17-bnr/Contactless/README.md

# Contactless
for Tokyo Tech Festival 2022
