17-bnr/Contactless/(list of files, cad)

Other CAD files:
Inventor/Dai/Dai.iam
Inventor/Dai/Dai.ipt
Inventor/Dai/DaiUe.ipt
Inventor/Dai/Naname.ipt
Inventor/Dai/OldVersions/Dai.0006.iam
Inventor/Dai/OldVersions/Dai.0006.ipt
Inventor/Dai/OldVersions/DaiUe.0001.ipt
Inventor/Dai/OldVersions/Naname.0003.ipt
Inventor/Dai/OldVersions/Shita.0002.ipt
Inventor/Dai/OldVersions/Tate.0004.ipt
Inventor/Dai/Shita.ipt
Inventor/Dai/Soko.ipt
Inventor/Dai/Tate.ipt
Inventor/Kitai/ConPCB.ipt
Inventor/Kitai/Dai.ipt
Inventor/Kitai/Gamen.ipt
Inventor/Kitai/IndiPCB.ipt
Inventor/Kitai/Ita.ipt
Inventor/Kitai/Kitai.iam
Inventor/Kitai/OldVersions/Dai.0004.ipt
Inventor/Kitai/OldVersions/Ita.0001.ipt
Inventor/Kitai/OldVersions/Kitai.0011.iam
Inventor/Kitai/OldVersions/SokuTate.0003.ipt
Inventor/Kitai/OldVersions/SokuYokoUe.0001.ipt
Inventor/Kitai/OldVersions/Tate.0004.ipt
Inventor/Kitai/OldVersions/Yoko.0002.ipt
Inventor/Kitai/OldVersions/YokoUe.0003.ipt
Inventor/Kitai/SokuTate.ipt
Inventor/Kitai/SokuYoko.ipt
Inventor/Kitai/SokuYokoUe.ipt
Inventor/Kitai/Tate.ipt
Inventor/Kitai/Yoko.ipt
Inventor/Kitai/YokoUe.ipt
