17-bnr/Contactless/LTspice/SoundSim.asc

V1: voltage; PULSE(0 3.3 0 1u 1u 1.28m 2.55m)
Named nets: 0, out
.wave output.wav 16 44.1k V(out)
.tran 1
