17-bnr/Contactless/EAGLE/ContactlessIndi/ContactlessIndi.brd

## EAGLE design EAGLE/ContactlessIndi/ContactlessIndi.brd (2022-10-10)

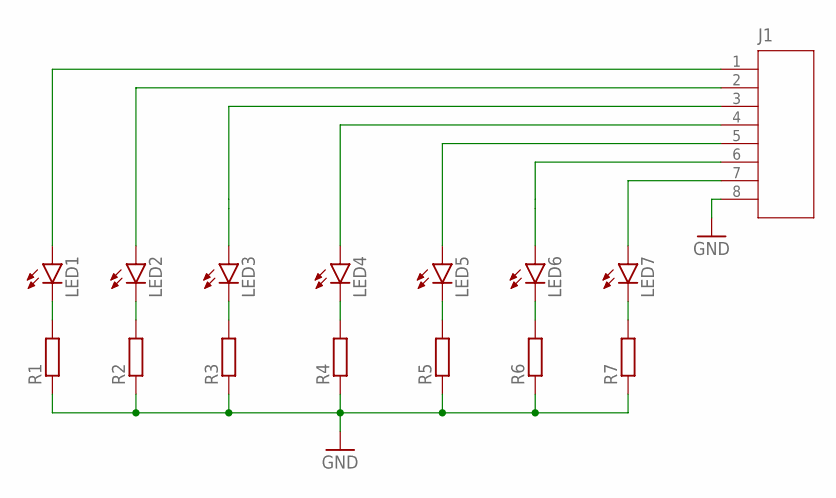
[picture p1: schematic ContactlessIndi.sch]

Parts:
J1: PINHEADER-818*1; PINHEADER-8*1
LED1, LED2, LED3, LED4, LED5, LED6, LED7: LED5MM
R1, R2, R3, R4, R5, R6, R7: R-EU_R1206; R1206

Connections:
GND: J1.8, R1.1, R2.1, R3.1, R4.1, R5.1, R6.1, R7.1
unnamed: LED1.K (C), R1.2
unnamed: LED2.K (C), R2.2
unnamed: LED3.K (C), R3.2
unnamed: LED4.K (C), R4.2
unnamed: LED5.K (C), R5.2
unnamed: LED6.K (C), R6.2
unnamed: LED7.K (C), R7.2
unnamed: J1.7, LED7.A
unnamed: J1.6, LED6.A
unnamed: J1.5, LED5.A
unnamed: J1.4, LED4.A
unnamed: J1.3, LED3.A
unnamed: J1.2, LED2.A
unnamed: J1.1, LED1.A

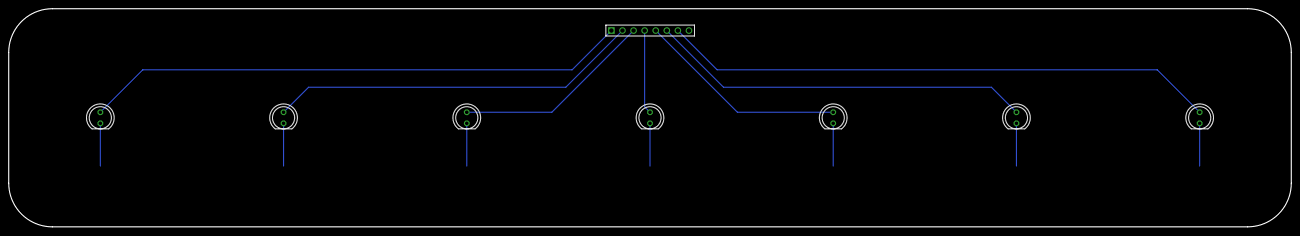
[picture p2: board ContactlessIndi.brd from above]

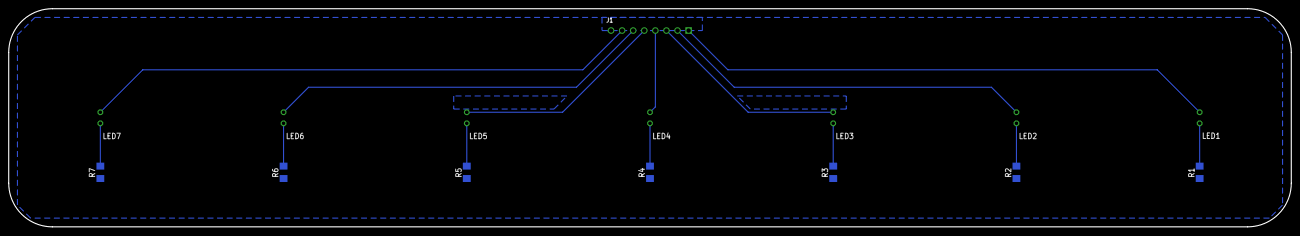
[picture p3: board ContactlessIndi.brd from below]

Board: 2 copper layers, 294.0 x 50.0 mm, 15 parts (7 on the bottom side), 15 nets.
