17-bnr/Contactless/EAGLE/ContactlessMain/ContactlessMain.brd

## EAGLE design EAGLE/ContactlessMain/ContactlessMain.brd (2022-10-10)

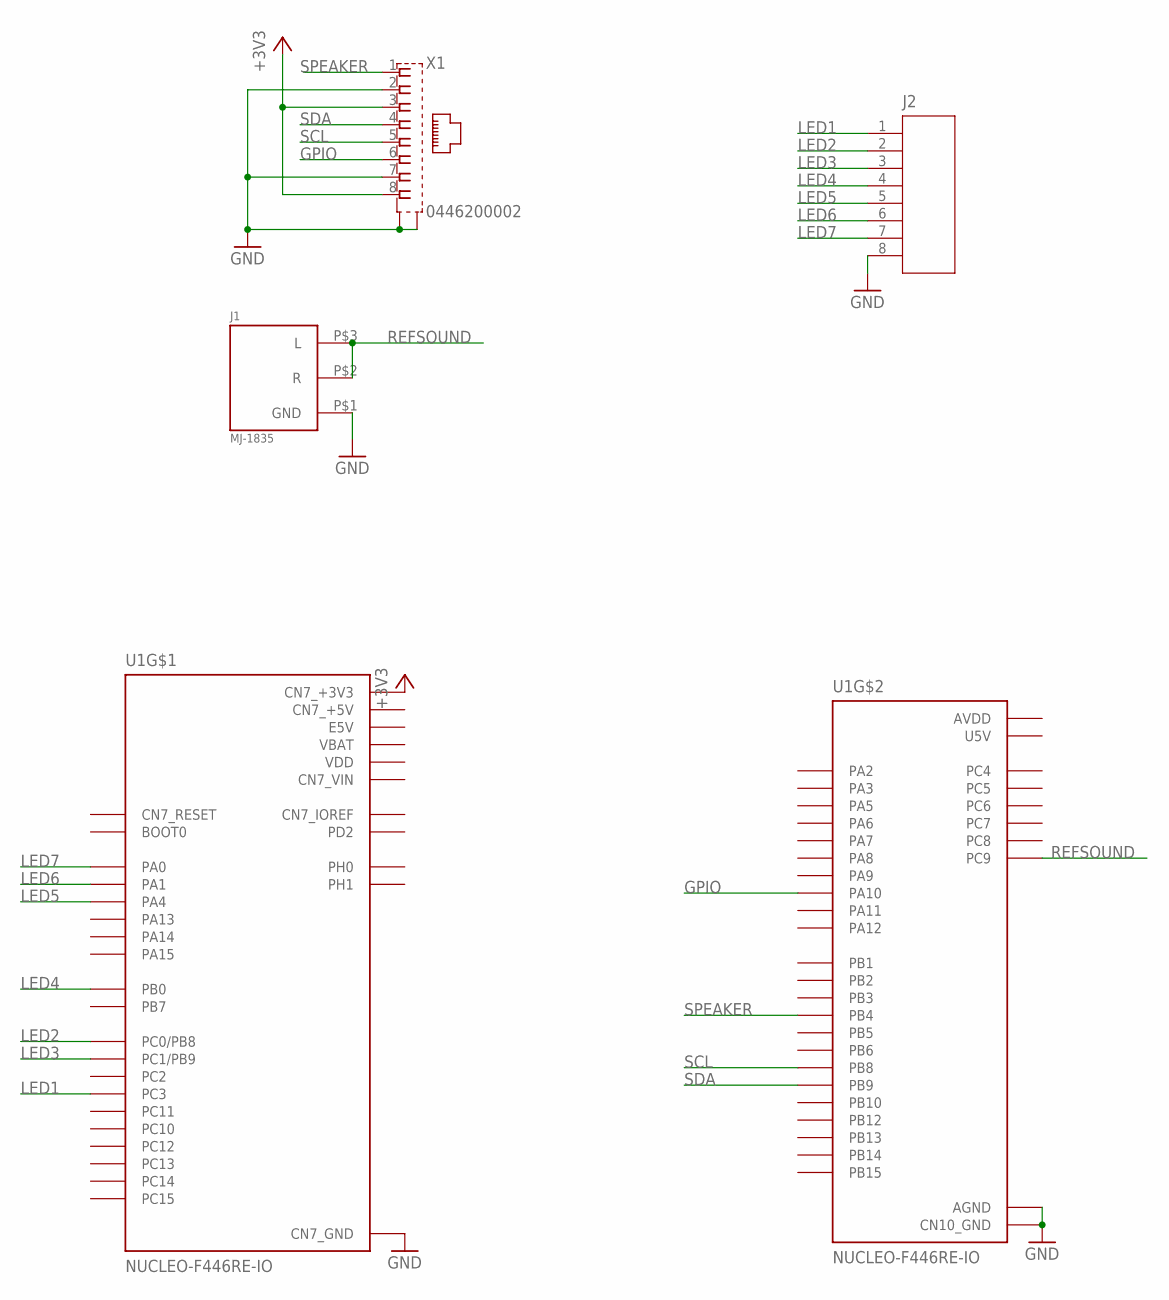
[picture p4: schematic ContactlessMain.sch]

Parts:
J1: MJ-1835
J2: PINHEADER-818*1; PINHEADER-8*1
U1: NUCLEO-F446RE-IO; MODULE_NUCLEO-F446RE
X1: 0446200002

Connections:
+3V3: U1.CN7_16 (CN7_+3V3), X1.3, X1.8
AVDD: U1.CN10_7 (AVDD)
CN7_+5V: U1.CN7_18 (CN7_+5V)
CN7_VIN: U1.CN7_24 (CN7_VIN)
E5V: U1.CN7_6 (E5V)
GND: J1.P$1 (GND), J2.8, U1.CN7_8 (CN7_GND), U1.CN7_19 (CN7_GND), U1.CN7_20 (CN7_GND), U1.CN7_22 (CN7_GND), U1.CN10_9 (CN10_GND), U1.CN10_20 (CN10_GND), U1.CN10_32 (AGND), X1.2, X1.7, X1.S@1 (S1), X1.S@2 (S2)
GPIO: U1.CN10_33 (PA10), X1.6
LED1: J2.1, U1.CN7_37 (PC3)
LED2: J2.2, U1.CN7_38 (PC0/PB8)
LED3: J2.3, U1.CN7_36 (PC1/PB9)
LED4: J2.4, U1.CN7_34 (PB0)
LED5: J2.5, U1.CN7_32 (PA4)
LED6: J2.6, U1.CN7_30 (PA1)
LED7: J2.7, U1.CN7_28 (PA0)
REFSOUND: J1.P$2 (R), J1.P$3 (L), U1.CN10_1 (PC9)
SCL: U1.CN10_3 (PB8), X1.5
SDA: U1.CN10_5 (PB9), X1.4
SPEAKER: U1.CN10_27 (PB4), X1.1
U5V: U1.CN10_8 (U5V)
VBAT: U1.CN7_33 (VBAT)
VDD: U1.CN7_5 (VDD)

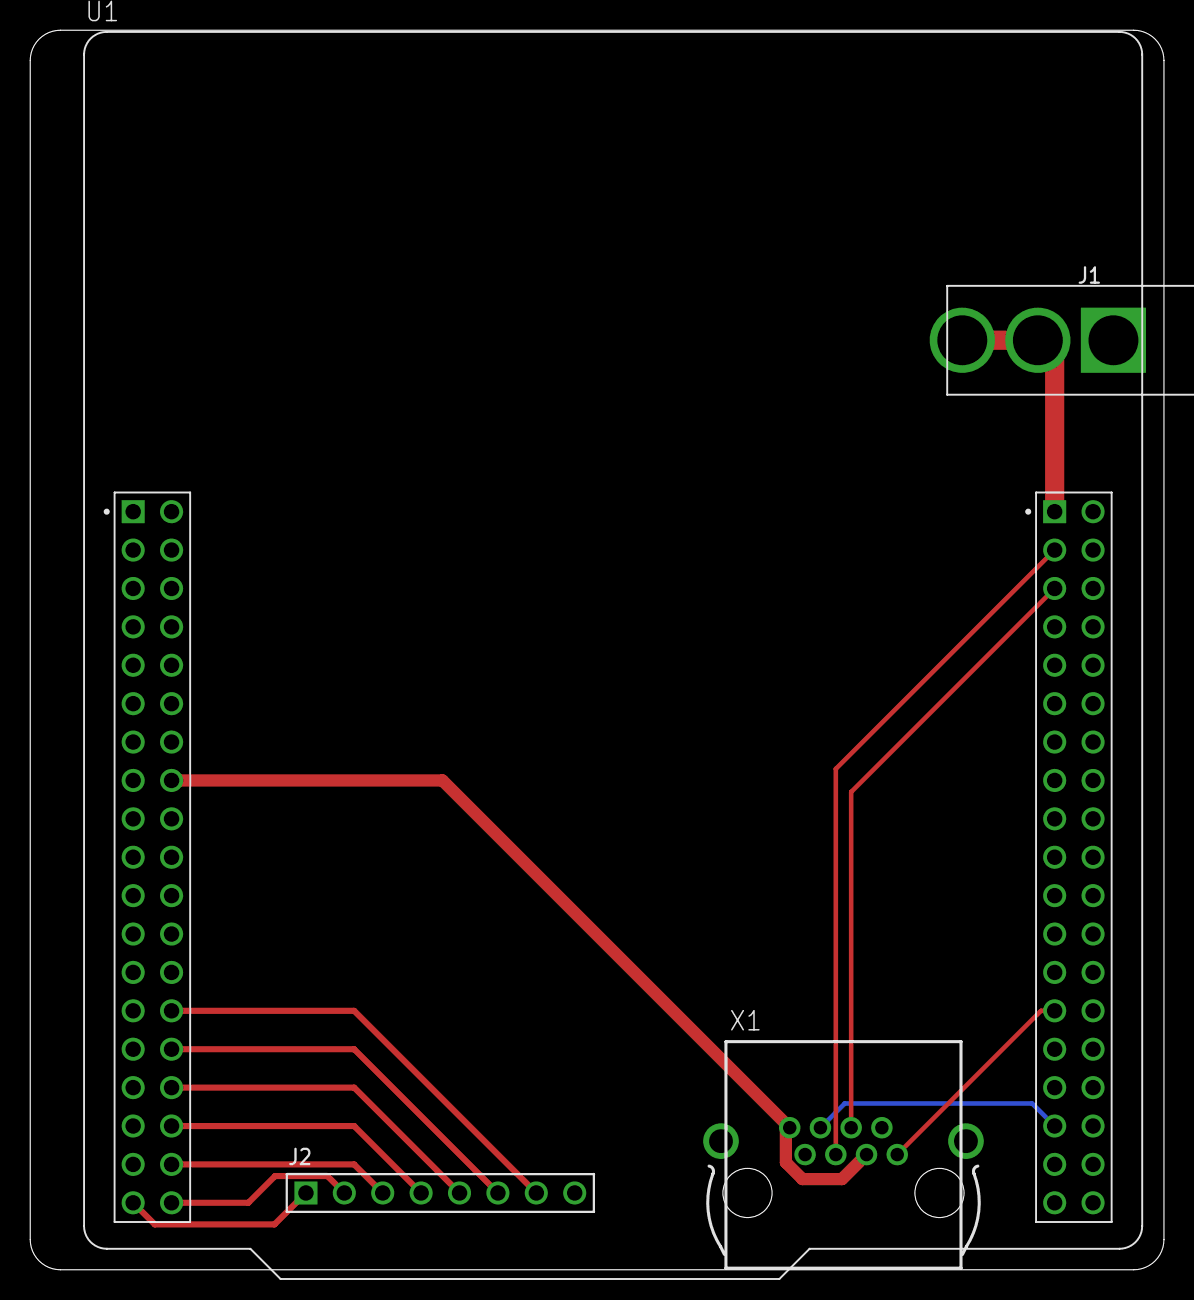
[picture p5: board ContactlessMain.brd from above]

Board: 2 copper layers, 75.0 x 82.0 mm, 4 parts (0 on the bottom side), 14 nets.
