17-bnr/Contactless/EAGLE/ContactlessCon/ContactlessCon.brd

## EAGLE design EAGLE/ContactlessCon/ContactlessCon.brd (2022-10-10)

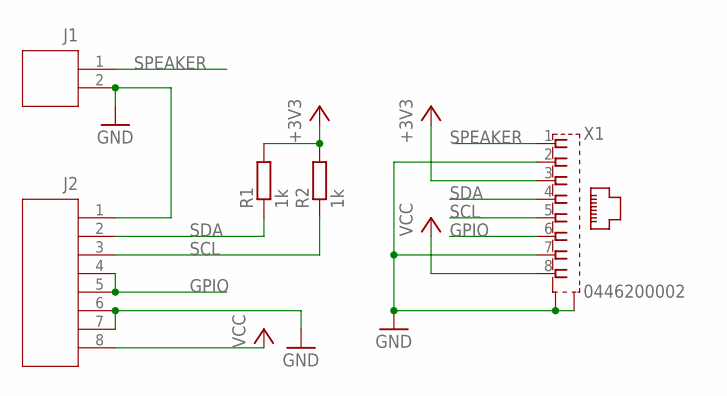
[picture p6: schematic ContactlessCon.sch]

Parts:
J1: PINHEADER-212*1; PINHEADER-2*1
J2: PINHEADER-818*1; PINHEADER-8*1
R1, R2: 1k; R1206
X1: 0446200002

Connections:
+3V3: R1.2, R2.2, X1.3
GND: J1.2, J2.1, J2.6, J2.7, X1.2, X1.7, X1.S@1 (S1), X1.S@2 (S2)
GPIO: J2.4, J2.5, X1.6
SCL: J2.3, R2.1, X1.5
SDA: J2.2, R1.1, X1.4
SPEAKER: J1.1, X1.1
VCC: J2.8, X1.8

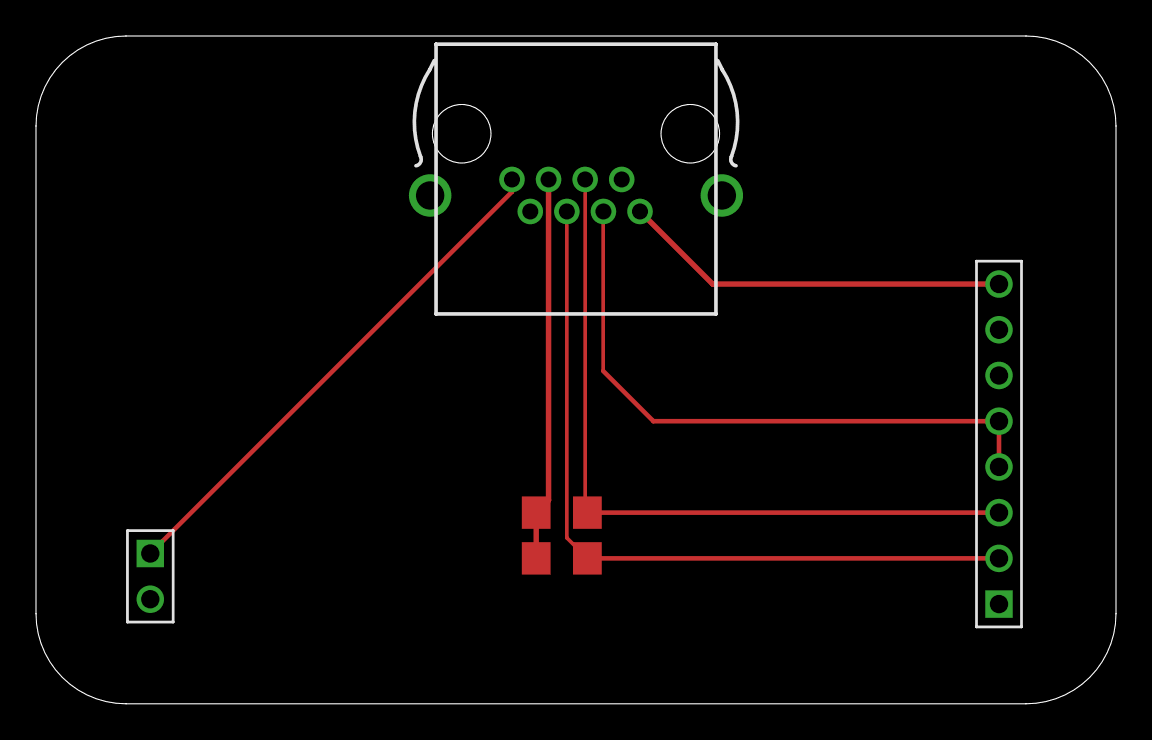
[picture p7: board ContactlessCon.brd from above]

Board: 2 copper layers, 60.0 x 37.1 mm, 5 parts (0 on the bottom side), 7 nets.
