17-bnr/Contactless/ContactlessNucleo/Core/Src/main.c

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
/* Includes ------------------------------------------------------------------*/
#include "main.h"

/* USER CODE BEGIN Includes */
#include "stdio.h"
#include "math.h"

/* USER CODE END Includes */

I2C_HandleTypeDef hi2c1;
DMA_HandleTypeDef hdma_i2c1_rx;
DMA_HandleTypeDef hdma_i2c1_tx;

TIM_HandleTypeDef htim2;
TIM_HandleTypeDef htim3;
TIM_HandleTypeDef htim8;

UART_HandleTypeDef huart2;
DMA_HandleTypeDef hdma_usart2_tx;

/* USER CODE BEGIN PV */
const static uint16_t address = 0x80;
const static uint16_t addressR = address+1;
static uint8_t rx_buf[2] = {};
static uint8_t tx_on_buf[2] = {0xE8,0x00};
static uint8_t tx_off_buf[2] = {0xE8,0x01};
static uint8_t tx_buf[1] = {0x5E};
static uint32_t tone_array[12]
= {53639,50540,47780,45015,42552,40114,37837,35713,33734,31817,30042,28339};
/* USER CODE END PV */

void SystemClock_Config(void);
static void MX_DMA_Init(void);
static void MX_I2C1_Init(void);
static void MX_TIM2_Init(void);
static void MX_USART2_UART_Init(void);
static void MX_GPIO_Init(void);
static void MX_TIM3_Init(void);
static void MX_TIM8_Init(void);
/* USER CODE BEGIN 0 */
enum Tone {C=0,Cs,D,Ef,E,F,Fs,G,Gs,A,Bf,B,none};
enum Tone ASpeakerOn(uint16_t distance)
{
  switch (distance)
  {
  case 3: case 4:
    TIM3->ARR = tone_array[C];
    TIM3->CCR1 = (TIM3->ARR)/2;
    HAL_TIM_PWM_Start(&htim3,TIM_CHANNEL_1);
    return C;
    break;
  case 5: case 6:
    TIM3->ARR = tone_array[Cs];
    TIM3->CCR1 = (TIM3->ARR)/2;
    HAL_TIM_PWM_Start(&htim3,TIM_CHANNEL_1);
    return Cs;
  case 7: case 8:
    TIM3->ARR = tone_array[D];
    TIM3->CCR1 = (TIM3->ARR)/2;
    HAL_TIM_PWM_Start(&htim3,TIM_CHANNEL_1);
    return D;
  case 9: case 10:
    TIM3->ARR = tone_array[Ef];
    TIM3->CCR1 = (TIM3->ARR)/2;
    HAL_TIM_PWM_Start(&htim3,TIM_CHANNEL_1);
    return Ef;
  case 11: case 12: case 13:
    TIM3->ARR = tone_array[E];
    TIM3->CCR1 = (TIM3->ARR)/2;
    HAL_TIM_PWM_Start(&htim3,TIM_CHANNEL_1);
    return E;
  case 14: case 15: case 16:
    TIM3->ARR = tone_array[F];
    TIM3->CCR1 = (TIM3->ARR)/2;
    HAL_TIM_PWM_Start(&htim3,TIM_CHANNEL_1);
    return F;
  case 17: case 18: case 19: case 20:
    TIM3->ARR = tone_array[Fs];
    TIM3->CCR1 = (TIM3->ARR)/2;
    HAL_TIM_PWM_Start(&htim3,TIM_CHANNEL_1);
    return Fs;
  case 21: case 22: case 23: case 24:
    TIM3->ARR = tone_array[G];
    TIM3->CCR1 = (TIM3->ARR)/2;
    HAL_TIM_PWM_Start(&htim3,TIM_CHANNEL_1);
    return G;
  case 25: case 26: case 27: case 28:
    TIM3->ARR = tone_array[Gs];
    TIM3->CCR1 = (TIM3->ARR)/2;
    HAL_TIM_PWM_Start(&htim3,TIM_CHANNEL_1);
    return Gs;
  case 29: case 30: case 31: case 32: case 33: case 34:
    TIM3->ARR = tone_array[A];
    TIM3->CCR1 = (TIM3->ARR)/2;
    HAL_TIM_PWM_Start(&htim3,TIM_CHANNEL_1);
    return A;
  case 35: case 36: case 37: case 38: 
    TIM3->ARR = tone_array[Bf];
    TIM3->CCR1 = (TIM3->ARR)/2;
    HAL_TIM_PWM_Start(&htim3,TIM_CHANNEL_1);
    return Bf;
  case 39: case 40: case 41: case 42:
    TIM3->ARR = tone_array[B];
    TIM3->CCR1 = (TIM3->ARR)/2;
    HAL_TIM_PWM_Start(&htim3,TIM_CHANNEL_1);
    return B;
  default:
    HAL_TIM_PWM_Stop(&htim3,TIM_CHANNEL_1);
    return none;
    break;
  }
}

enum Tone SpeakerOn(uint16_t distance)
{
  switch (distance)
  {
  case 3: case 4:
    TIM3->ARR = tone_array[C];
    TIM3->CCR1 = (TIM3->ARR)/2;
    HAL_TIM_PWM_Start(&htim3,TIM_CHANNEL_1);
    return C;
    break;
  case 5: case 6:
    TIM3->ARR = tone_array[Cs];
    TIM3->CCR1 = (TIM3->ARR)/2;
    HAL_TIM_PWM_Start(&htim3,TIM_CHANNEL_1);
    return Cs;
  case 7: case 8:
    TIM3->ARR = tone_array[D];
    TIM3->CCR1 = (TIM3->ARR)/2;
    HAL_TIM_PWM_Start(&htim3,TIM_CHANNEL_1);
    return D;
  case 9: case 10:
    TIM3->ARR = tone_array[Ef];
    TIM3->CCR1 = (TIM3->ARR)/2;
    HAL_TIM_PWM_Start(&htim3,TIM_CHANNEL_1);
    return Ef;
  case 11: case 12: case 13:
    TIM3->ARR = tone_array[E];
    TIM3->CCR1 = (TIM3->ARR)/2;
    HAL_TIM_PWM_Start(&htim3,TIM_CHANNEL_1);
    return E;
  case 14: case 15: case 16:
    TIM3->ARR = tone_array[F];
    TIM3->CCR1 = (TIM3->ARR)/2;
    HAL_TIM_PWM_Start(&htim3,TIM_CHANNEL_1);
    return F;
  case 17: case 18: case 19: case 20:
    TIM3->ARR = tone_array[Fs];
    TIM3->CCR1 = (TIM3->ARR)/2;
    HAL_TIM_PWM_Start(&htim3,TIM_CHANNEL_1);
    return Fs;
  case 21: case 22: case 23: case 24:
    TIM3->ARR = tone_array[G];
    TIM3->CCR1 = (TIM3->ARR)/2;
    HAL_TIM_PWM_Start(&htim3,TIM_CHANNEL_1);
    return G;
  case 25: case 26: case 27: case 28:
    TIM3->ARR = tone_array[Gs];
    TIM3->CCR1 = (TIM3->ARR)/2;
    HAL_TIM_PWM_Start(&htim3,TIM_CHANNEL_1);
    return Gs;
  case 29: case 30: case 31: case 32: case 33:
    TIM3->ARR = tone_array[A];
    TIM3->CCR1 = (TIM3->ARR)/2;
    HAL_TIM_PWM_Start(&htim3,TIM_CHANNEL_1);
    return A;
  case 34: case 35: case 36: case 37: case 38: 
    TIM3->ARR = tone_array[Bf];
    TIM3->CCR1 = (TIM3->ARR)/2;
    HAL_TIM_PWM_Start(&htim3,TIM_CHANNEL_1);
    return Bf;
  case 39: case 40: case 41: case 42: case 43: 
    TIM3->ARR = tone_array[B];
    TIM3->CCR1 = (TIM3->ARR)/2;
    HAL_TIM_PWM_Start(&htim3,TIM_CHANNEL_1);
    return B;
  default:
    HAL_TIM_PWM_Stop(&htim3,TIM_CHANNEL_1);
    return none;
    break;
  }
}

void SpeakerOff()
{
  HAL_TIM_PWM_Stop(&htim3,TIM_CHANNEL_1);
}

void ASoundOn()
{
  TIM8->ARR = tone_array[A];
  TIM8->CCR4 = (TIM8->ARR)/2;
  HAL_TIM_PWM_Start(&htim8,TIM_CHANNEL_4);
}

void RefSoundOn(uint32_t time)
{
  TIM8->ARR = tone_array[time%12];
  TIM8->CCR4 = (TIM8->ARR)/2;
  HAL_TIM_PWM_Start(&htim8,TIM_CHANNEL_4);
}

void SoundOff()
{
  HAL_TIM_PWM_Stop(&htim8,TIM_CHANNEL_4);
}

enum GameMode {Wait,Start,Load,Game,Clear,Finish};
static enum GameMode mode = Wait;
static uint32_t time_counter = 0;
static uint32_t game_time = 0;
void HAL_TIM_PeriodElapsedCallback(TIM_HandleTypeDef *htim)
{
  if(htim==&htim2)
  {
    time_counter++;
    switch (mode)
    {
    case Wait:
      SpeakerOff();
      SoundOff();
      HAL_GPIO_WritePin(LED1_GPIO_Port,LED1_Pin,GPIO_PIN_SET);
      HAL_GPIO_WritePin(LED2_GPIO_Port,LED2_Pin,GPIO_PIN_SET);
      HAL_GPIO_WritePin(LED3_GPIO_Port,LED3_Pin,GPIO_PIN_SET);
      HAL_GPIO_WritePin(LED4_GPIO_Port,LED4_Pin,GPIO_PIN_RESET);
      HAL_GPIO_WritePin(LED5_GPIO_Port,LED5_Pin,GPIO_PIN_SET);
      HAL_GPIO_WritePin(LED6_GPIO_Port,LED6_Pin,GPIO_PIN_SET);
      HAL_GPIO_WritePin(LED7_GPIO_Port,LED7_Pin,GPIO_PIN_SET);
      HAL_I2C_Master_Transmit(&hi2c1,address,tx_on_buf,2,1);
      HAL_I2C_Master_Transmit_DMA(&hi2c1,address,tx_buf,1);
      break;
    case Start:
      ASoundOn();
      HAL_I2C_Master_Transmit(&hi2c1,address,tx_on_buf,2,1);
      HAL_I2C_Master_Transmit_DMA(&hi2c1,address,tx_buf,1);
      break;
    case Load:
      SpeakerOff();
      SoundOff();
      HAL_GPIO_WritePin(LED1_GPIO_Port,LED1_Pin,GPIO_PIN_RESET);
      HAL_GPIO_WritePin(LED2_GPIO_Port,LED2_Pin,GPIO_PIN_RESET);
      HAL_GPIO_WritePin(LED3_GPIO_Port,LED3_Pin,GPIO_PIN_RESET);
      HAL_GPIO_WritePin(LED4_GPIO_Port,LED4_Pin,GPIO_PIN_RESET);
      HAL_GPIO_WritePin(LED5_GPIO_Port,LED5_Pin,GPIO_PIN_RESET);
      HAL_GPIO_WritePin(LED6_GPIO_Port,LED6_Pin,GPIO_PIN_RESET);
      HAL_GPIO_WritePin(LED7_GPIO_Port,LED7_Pin,GPIO_PIN_RESET);
      if(time_counter>=60)
      {
        time_counter = 0;
        mode = Game;
      }
      break;
    case Game:
      RefSoundOn(game_time);
      HAL_I2C_Master_Transmit(&hi2c1,address,tx_on_buf,2,1);
      HAL_I2C_Master_Transmit_DMA(&hi2c1,address,tx_buf,1);
      break;
    case Clear:
      SpeakerOff();
      SoundOff();
      HAL_I2C_Master_Transmit(&hi2c1,address,tx_on_buf,2,1);
      HAL_I2C_Master_Transmit_DMA(&hi2c1,address,tx_buf,1);
      break;
    case Finish:
      SpeakerOff();
      SoundOff();
      HAL_GPIO_WritePin(LED1_GPIO_Port,LED1_Pin,GPIO_PIN_RESET);
      HAL_GPIO_WritePin(LED2_GPIO_Port,LED2_Pin,GPIO_PIN_RESET);
      HAL_GPIO_WritePin(LED3_GPIO_Port,LED3_Pin,GPIO_PIN_RESET);
      HAL_GPIO_WritePin(LED4_GPIO_Port,LED4_Pin,GPIO_PIN_SET);
      HAL_GPIO_WritePin(LED5_GPIO_Port,LED5_Pin,GPIO_PIN_RESET);
      HAL_GPIO_WritePin(LED6_GPIO_Port,LED6_Pin,GPIO_PIN_RESET);
      HAL_GPIO_WritePin(LED7_GPIO_Port,LED7_Pin,GPIO_PIN_RESET);
      if(time_counter>=60)
      {
        time_counter = 0;
        mode = Wait;
      }
      break;
    default:
      break;
    }
  }
}

void HAL_I2C_MasterTxCpltCallback(I2C_HandleTypeDef *hi2c)
{
  if(hi2c==&hi2c1)
  {
    HAL_I2C_Master_Receive_DMA(&hi2c1,addressR,rx_buf,2);
  }
}

static uint32_t strike_counter = 0;
void HAL_I2C_MasterRxCpltCallback(I2C_HandleTypeDef *hi2c)
{
  if(hi2c==&hi2c1)
  {
    HAL_I2C_Master_Transmit(&hi2c1,address,tx_off_buf,2,1);
    uint16_t distance = (rx_buf[0]<<4|rx_buf[1])/64;
    enum Tone speaker_tone = none;
    switch (mode)
    {
      case Wait:
      if(distance<50)
      {
        strike_counter++;
        if(strike_counter>=20)
        {
          strike_counter = 0;
          time_counter = 0;
          mode = Start;
        }
      }
      else
      {
        strike_counter = 0;
      }
      break;
    case Start:
      speaker_tone = ASpeakerOn(distance);
      if(distance>=63)
      {
        HAL_GPIO_WritePin(LED1_GPIO_Port,LED1_Pin,GPIO_PIN_RESET);
        HAL_GPIO_WritePin(LED2_GPIO_Port,LED2_Pin,GPIO_PIN_RESET);
        HAL_GPIO_WritePin(LED3_GPIO_Port,LED3_Pin,GPIO_PIN_RESET);
        HAL_GPIO_WritePin(LED4_GPIO_Port,LED4_Pin,GPIO_PIN_RESET);
        HAL_GPIO_WritePin(LED5_GPIO_Port,LED5_Pin,GPIO_PIN_RESET);
        HAL_GPIO_WritePin(LED6_GPIO_Port,LED6_Pin,GPIO_PIN_RESET);
        HAL_GPIO_WritePin(LED7_GPIO_Port,LED7_Pin,GPIO_PIN_RESET);
      }
      else
      {
        switch (speaker_tone-A)
        {
        case -9: case -8: case -7: case -6: case -5: case -4: case -3:
          HAL_GPIO_WritePin(LED1_GPIO_Port,LED1_Pin,GPIO_PIN_SET);
          HAL_GPIO_WritePin(LED2_GPIO_Port,LED2_Pin,GPIO_PIN_RESET);
          HAL_GPIO_WritePin(LED3_GPIO_Port,LED3_Pin,GPIO_PIN_RESET);
          HAL_GPIO_WritePin(LED4_GPIO_Port,LED4_Pin,GPIO_PIN_RESET);
          HAL_GPIO_WritePin(LED5_GPIO_Port,LED5_Pin,GPIO_PIN_RESET);
          HAL_GPIO_WritePin(LED6_GPIO_Port,LED6_Pin,GPIO_PIN_RESET);
          HAL_GPIO_WritePin(LED7_GPIO_Port,LED7_Pin,GPIO_PIN_RESET);
          break;
        case -2:
          HAL_GPIO_WritePin(LED1_GPIO_Port,LED1_Pin,GPIO_PIN_RESET);
          HAL_GPIO_WritePin(LED2_GPIO_Port,LED2_Pin,GPIO_PIN_SET);
          HAL_GPIO_WritePin(LED3_GPIO_Port,LED3_Pin,GPIO_PIN_RESET);
          HAL_GPIO_WritePin(LED4_GPIO_Port,LED4_Pin,GPIO_PIN_RESET);
          HAL_GPIO_WritePin(LED5_GPIO_Port,LED5_Pin,GPIO_PIN_RESET);
          HAL_GPIO_WritePin(LED6_GPIO_Port,LED6_Pin,GPIO_PIN_RESET);
          HAL_GPIO_WritePin(LED7_GPIO_Port,LED7_Pin,GPIO_PIN_RESET);
          break;
        case -1:
          HAL_GPIO_WritePin(LED1_GPIO_Port,LED1_Pin,GPIO_PIN_RESET);
          HAL_GPIO_WritePin(LED2_GPIO_Port,LED2_Pin,GPIO_PIN_RESET);
          HAL_GPIO_WritePin(LED3_GPIO_Port,LED3_Pin,GPIO_PIN_SET);
          HAL_GPIO_WritePin(LED4_GPIO_Port,LED4_Pin,GPIO_PIN_RESET);
          HAL_GPIO_WritePin(LED5_GPIO_Port,LED5_Pin,GPIO_PIN_RESET);
          HAL_GPIO_WritePin(LED6_GPIO_Port,LED6_Pin,GPIO_PIN_RESET);
          HAL_GPIO_WritePin(LED7_GPIO_Port,LED7_Pin,GPIO_PIN_RESET);
          break;
        case 0:
          HAL_GPIO_WritePin(LED1_GPIO_Port,LED1_Pin,GPIO_PIN_RESET);
          HAL_GPIO_WritePin(LED2_GPIO_Port,LED2_Pin,GPIO_PIN_RESET);
          HAL_GPIO_WritePin(LED3_GPIO_Port,LED3_Pin,GPIO_PIN_RESET);
          HAL_GPIO_WritePin(LED4_GPIO_Port,LED4_Pin,GPIO_PIN_SET);
          HAL_GPIO_WritePin(LED5_GPIO_Port,LED5_Pin,GPIO_PIN_RESET);
          HAL_GPIO_WritePin(LED6_GPIO_Port,LED6_Pin,GPIO_PIN_RESET);
          HAL_GPIO_WritePin(LED7_GPIO_Port,LED7_Pin,GPIO_PIN_RESET);
          break;
        case 1:
          HAL_GPIO_WritePin(LED1_GPIO_Port,LED1_Pin,GPIO_PIN_RESET);
          HAL_GPIO_WritePin(LED2_GPIO_Port,LED2_Pin,GPIO_PIN_RESET);
          HAL_GPIO_WritePin(LED3_GPIO_Port,LED3_Pin,GPIO_PIN_RESET);
          HAL_GPIO_WritePin(LED4_GPIO_Port,LED4_Pin,GPIO_PIN_RESET);
          HAL_GPIO_WritePin(LED5_GPIO_Port,LED5_Pin,GPIO_PIN_SET);
          HAL_GPIO_WritePin(LED6_GPIO_Port,LED6_Pin,GPIO_PIN_RESET);
          HAL_GPIO_WritePin(LED7_GPIO_Port,LED7_Pin,GPIO_PIN_RESET);
          break;
        case 2:
          HAL_GPIO_WritePin(LED1_GPIO_Port,LED1_Pin,GPIO_PIN_RESET);
          HAL_GPIO_WritePin(LED2_GPIO_Port,LED2_Pin,GPIO_PIN_RESET);
          HAL_GPIO_WritePin(LED3_GPIO_Port,LED3_Pin,GPIO_PIN_RESET);
          HAL_GPIO_WritePin(LED4_GPIO_Port,LED4_Pin,GPIO_PIN_RESET);
          HAL_GPIO_WritePin(LED5_GPIO_Port,LED5_Pin,GPIO_PIN_RESET);
          HAL_GPIO_WritePin(LED6_GPIO_Port,LED6_Pin,GPIO_PIN_SET);
          HAL_GPIO_WritePin(LED7_GPIO_Port,LED7_Pin,GPIO_PIN_RESET);
          break;
        default:
          HAL_GPIO_WritePin(LED1_GPIO_Port,LED1_Pin,GPIO_PIN_RESET);
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
          HAL_GPIO_WritePin(LED5_GPIO_Port,LED5_Pin,GPIO_PIN_RESET);
          HAL_GPIO_WritePin(LED6_GPIO_Port,LED6_Pin,GPIO_PIN_SET);
          HAL_GPIO_WritePin(LED7_GPIO_Port,LED7_Pin,GPIO_PIN_RESET);
          break;
        case 3:
          HAL_GPIO_WritePin(LED1_GPIO_Port,LED1_Pin,GPIO_PIN_RESET);
          HAL_GPIO_WritePin(LED2_GPIO_Port,LED2_Pin,GPIO_PIN_RESET);
          HAL_GPIO_WritePin(LED3_GPIO_Port,LED3_Pin,GPIO_PIN_RESET);
          HAL_GPIO_WritePin(LED4_GPIO_Port,LED4_Pin,GPIO_PIN_RESET);
          HAL_GPIO_WritePin(LED5_GPIO_Port,LED5_Pin,GPIO_PIN_RESET);
          HAL_GPIO_WritePin(LED6_GPIO_Port,LED6_Pin,GPIO_PIN_RESET);
          HAL_GPIO_WritePin(LED7_GPIO_Port,LED7_Pin,GPIO_PIN_SET);
          break;
        default:
          HAL_GPIO_WritePin(LED1_GPIO_Port,LED1_Pin,GPIO_PIN_RESET);
          HAL_GPIO_WritePin(LED2_GPIO_Port,LED2_Pin,GPIO_PIN_RESET);
          HAL_GPIO_WritePin(LED3_GPIO_Port,LED3_Pin,GPIO_PIN_RESET);
          HAL_GPIO_WritePin(LED4_GPIO_Port,LED4_Pin,GPIO_PIN_RESET);
          HAL_GPIO_WritePin(LED5_GPIO_Port,LED5_Pin,GPIO_PIN_RESET);
          HAL_GPIO_WritePin(LED6_GPIO_Port,LED6_Pin,GPIO_PIN_RESET);
          HAL_GPIO_WritePin(LED7_GPIO_Port,LED7_Pin,GPIO_PIN_RESET);
          break;
        }
      }
      if(speaker_tone==(game_time%12))
      {
        strike_counter++;
        if(strike_counter>=15)
        {
          strike_counter = 0;
          game_time = time_counter;
          time_counter = 0;
          mode = Finish;
        }
      }
      else
      {
        strike_counter = 0;
      }
      break;
    case Clear:
      if(distance<10)
      {
        strike_counter++;
        if(strike_counter>=20)
        {
          strike_counter = 0;
          time_counter = 0;
          mode = Finish;
        }
      }
      else
      {
        strike_counter = 0;
      }
      break;
    default:
      break;
    }
    uint8_t tof_data[16] = {};
    snprintf((char*)tof_data,16,"%d,%ld,%ld\r\n",distance,time_counter,game_time);
    HAL_UART_Transmit_DMA(&huart2,tof_data,16);
  }
}
/* USER CODE END 0 */

/**
  * @brief  The application entry point.
  * @retval int
  */
int main(void)
{
  /* MCU Configuration--------------------------------------------------------*/

  /* Reset of all peripherals, Initializes the Flash interface and the Systick. */
  HAL_Init();

  /* Configure the system clock */
  SystemClock_Config();

  /* Initialize all configured peripherals */
  MX_DMA_Init();
  MX_I2C1_Init();
  MX_TIM2_Init();
  MX_USART2_UART_Init();
  MX_GPIO_Init();
  MX_TIM3_Init();
  MX_TIM8_Init();
  /* USER CODE BEGIN 2 */
  uint8_t uart_buf[] = "start\r\n";
  HAL_UART_Transmit(&huart2,uart_buf,sizeof(uart_buf),1000);
  HAL_GPIO_WritePin(GPIO_GPIO_Port,GPIO_Pin,SET);
  HAL_I2C_Master_Transmit(&hi2c1,address,tx_on_buf,2,1);
  TIM2->CNT = 0;
  TIM3->CNT = 0;
  TIM8->CNT = 0;
  HAL_TIM_Base_Start_IT(&htim2);
  /* USER CODE END 2 */

  /* Infinite loop */
  /* USER CODE BEGIN WHILE */
  while (1)
  {
    /* USER CODE END WHILE */

    /* USER CODE BEGIN 3 */
  }
  /* USER CODE END 3 */
}

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
