17-bnr/Contactless/ContactlessNucleo/ContactlessNucleo.ioc

Mcu.UserName=STM32F446RETx
PA0-WKUP.GPIO_Label=LED7
PA0-WKUP.Signal=GPIO_Output
PA1.GPIO_Label=LED6
PA1.Signal=GPIO_Output
PA10.GPIO_Label=GPIO
PA10.Signal=GPIO_Output
PA13.GPIO_Label=TMS
PA13.Signal=SYS_JTMS-SWDIO
PA14.GPIO_Label=TCK
PA14.Signal=SYS_JTCK-SWCLK
PA2.GPIO_Label=USART_TX
PA2.Signal=USART2_TX
PA3.GPIO_Label=USART_RX
PA3.Signal=USART2_RX
PA4.GPIO_Label=LED5
PA4.Signal=GPIO_Output
PA5.GPIO_Label=LD2 [Green Led]
PA5.Signal=GPIO_Output
PB0.GPIO_Label=LED4
PB0.Signal=GPIO_Output
PB3.GPIO_Label=SWO
PB3.Signal=SYS_JTDO-SWO
PB4.GPIO_Label=SPEAKER
PB4.Signal=S_TIM3_CH1
PB8.Signal=I2C1_SCL
PB9.Signal=I2C1_SDA
PC0.GPIO_Label=LED2
PC0.Signal=GPIO_Output
PC1.GPIO_Label=LED3
PC1.Signal=GPIO_Output
PC13.GPIO_Label=B1 [Blue PushButton]
PC13.Signal=GPXTI13
PC14-OSC32_IN.Signal=RCC_OSC32_IN
PC15-OSC32_OUT.Signal=RCC_OSC32_OUT
PC3.GPIO_Label=LED1
PC3.Signal=GPIO_Output
PC9.GPIO_Label=REFSOUND
PC9.Signal=S_TIM8_CH4
PH0-OSC_IN.Signal=RCC_OSC_IN
PH1-OSC_OUT.Signal=RCC_OSC_OUT
