17-bnr/Contactless/ContactlessNucleo/Core/Inc/main.h

#define B1_Pin GPIO_PIN_13
#define B1_GPIO_Port GPIOC
#define LED2_Pin GPIO_PIN_0
#define LED2_GPIO_Port GPIOC
#define LED3_Pin GPIO_PIN_1
#define LED3_GPIO_Port GPIOC
#define LED1_Pin GPIO_PIN_3
#define LED1_GPIO_Port GPIOC
#define LED7_Pin GPIO_PIN_0
#define LED7_GPIO_Port GPIOA
#define LED6_Pin GPIO_PIN_1
#define LED6_GPIO_Port GPIOA
#define USART_TX_Pin GPIO_PIN_2
#define USART_TX_GPIO_Port GPIOA
#define USART_RX_Pin GPIO_PIN_3
#define USART_RX_GPIO_Port GPIOA
#define LED5_Pin GPIO_PIN_4
#define LED5_GPIO_Port GPIOA
#define LD2_Pin GPIO_PIN_5
#define LD2_GPIO_Port GPIOA
#define LED4_Pin GPIO_PIN_0
#define LED4_GPIO_Port GPIOB
#define REFSOUND_Pin GPIO_PIN_9
#define REFSOUND_GPIO_Port GPIOC
#define GPIO_Pin GPIO_PIN_10
#define GPIO_GPIO_Port GPIOA
#define TMS_Pin GPIO_PIN_13
#define TMS_GPIO_Port GPIOA
#define TCK_Pin GPIO_PIN_14
#define TCK_GPIO_Port GPIOA
#define SWO_Pin GPIO_PIN_3
#define SWO_GPIO_Port GPIOB
#define SPEAKER_Pin GPIO_PIN_4
#define SPEAKER_GPIO_Port GPIOB
