17-bnr/Contactless/(commit log)

2022-09-15 ToFセンサでI2Cできた
2022-09-15 SHARPセンサでI2Cできた
2022-09-17 PWMで2つの音を出力した
2022-09-19 距離センサの値で音階を変わるようにした
2022-10-08 LTspice追加
2022-10-08 EAGLEフォルダ作成
2022-10-08 回路図作成
    [ContactlessCon.brd, ContactlessCon.sch]
2022-10-08 Conの配線終了
    [ContactlessCon.brd, ContactlessCon.sch]
2022-10-09 抵抗のvalueを追加
    [ContactlessCon.brd, ContactlessCon.sch]
2022-10-09 くっついてない電源を2つにわけてくっつけた
2022-10-09 Mainの回路図途中まで作成
    [ContactlessMain.sch]
2022-10-09 インジゲータ基板作成
    [ContactlessIndi.brd, ContactlessIndi.sch]
2022-10-09 コントローラ基板のシルクをすべて裏にした
    [ContactlessCon.brd]
2022-10-09 Main基板の配線作成
    [ContactlessMain.brd, ContactlessMain.sch]
2022-10-10 Main基板設計完了
2022-10-10 Gerber作成
    [ContactlessCon.GBL, ContactlessCon.GBO, ContactlessCon.GBP, ContactlessCon.GBS, ContactlessCon.GTL, ContactlessCon.GTO, ContactlessCon.GTP, ContactlessCon.GTS]
2022-10-20 実機に合わせてピンアサインを変更
2022-10-20 機体設計ver1完了
    [ConPCB.ipt, Dai.0003.ipt, Dai.ipt, Gamen.ipt, IndiPCB.ipt, Ita.0001.ipt, Ita.ipt, Kitai.0006.iam]
2022-10-20 timer2内でDMAのI2C実装
2022-10-20 i2cのあとにgpioをinitし，timer2の周期を20Hzにした
2022-10-20 LEDと距離センサでstateを実装
2022-10-22 ASoundOn実装
2022-10-22 LED以外のstartは実装
2022-10-22 status全て完了
2022-10-23 LED実装
2022-10-24 側面の設計
    [Dai.0003.ipt, Dai.0004.ipt, Dai.ipt, Kitai.0006.iam, Kitai.0011.iam, Kitai.iam, SokuTate.0002.ipt, SokuTate.ipt]
2022-10-24 Daiの設計途中
    [ConPCB.ipt, Dai.0001.ipt, Dai.0004.ipt, Dai.iam, Dai.ipt, DaiUe.ipt, Gamen.ipt, IndiPCB.ipt]
2022-10-26 Dai下以外設計完了
    [Dai.0001.ipt, Dai.0005.iam, Dai.0005.ipt, Dai.iam, Dai.ipt, DaiUe.0001.ipt, DaiUe.ipt, Naname.0001.ipt]
2022-10-27 台の設計完了
    [Dai.0005.iam, Dai.0005.ipt, Dai.0006.iam, Dai.0006.ipt, Dai.iam, Dai.ipt, Shita.0001.ipt, Shita.0002.ipt]
2022-10-28 本日はありがとうございましたのポスター作成
2022-10-28 ポスター作成
2022-11-01 本番で判定の微調整
